QATCH-Technologies/QATCH_MUX_PCB/SVG/QATCH_MUX_PCB_v1-front.png

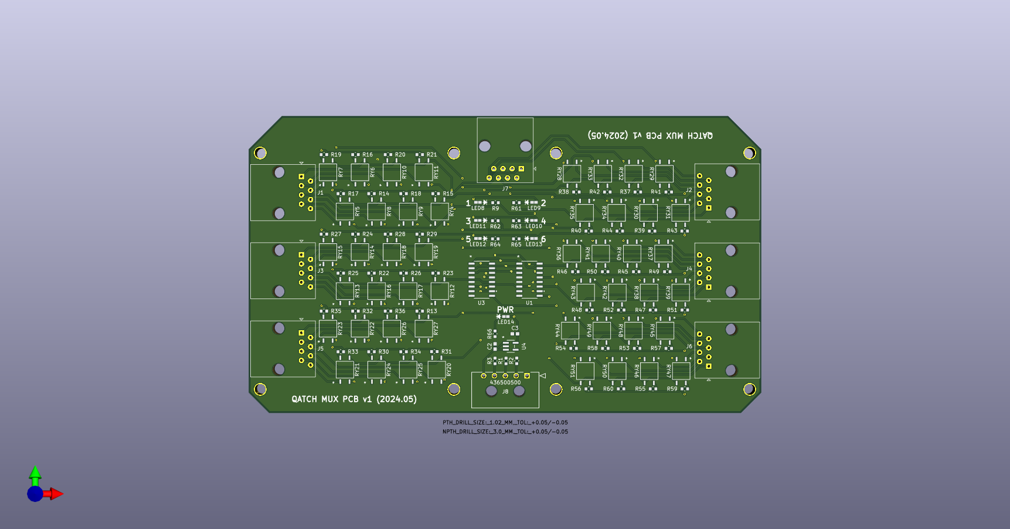
SVG/QATCH_MUX_PCB_v1-front.png
