QATCH-Technologies/QATCH_MUX_PCB/SVG/QATCH_MUX_PCB_v1-back.png

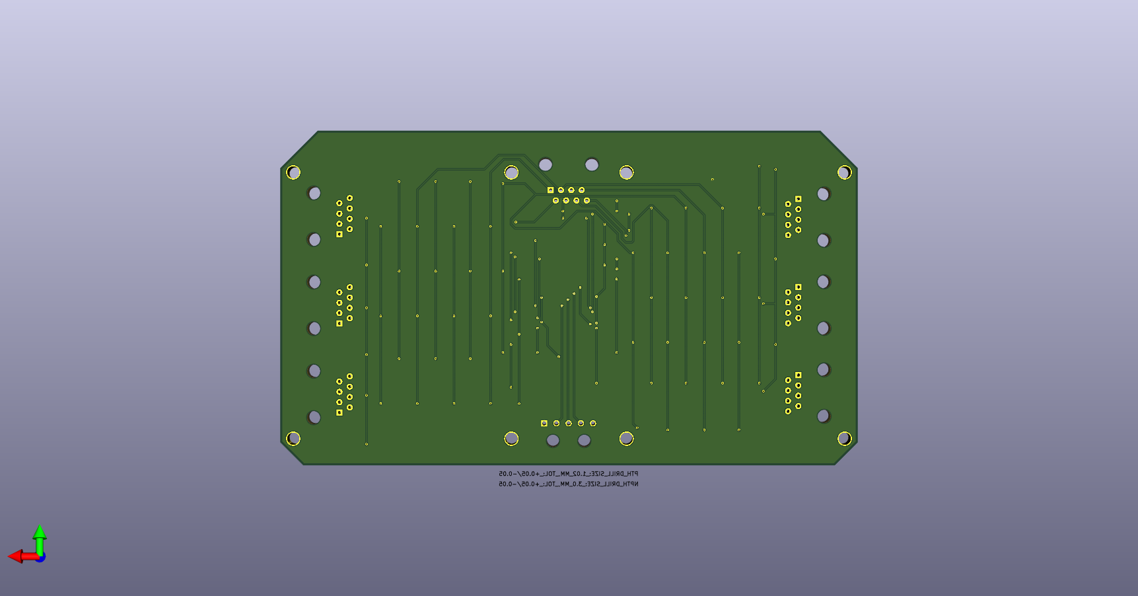
SVG/QATCH_MUX_PCB_v1-back.png
