QATCH-Technologies/QATCH_MUX_PCB/README.md

# QATCH_MUX_PCB
KiCad model for MUX switching multiplex system sensor signals with SSRs (4x6)
