QATCH-Technologies/QATCH_MUX_PCB/(commit log)

2024-05-16 Initial import of KiCad project
    [QATCH_MUX_PCB_v1.kicad_pcb, QATCH_MUX_PCB_v1.kicad_sch, QATCH_MUX_PCB_v1.sch, Scheme-it-export-QATCH-2024-04-09-15-52_MAX_PCB.sch, Scheme-it-export-QATCH-2024-04-09-15-52_QATCH_PCB.kicad_sch, Scheme-it-export-QATCH-2024-04-09-15-52_QATCH_PCB.sch, Scheme-it-export-QATCH-2024-04-09-15-52_TEC_PCB.sch]
2024-05-17 Add 10k pulldown resistors to MUX control input signals Add fabrication outputs
    [BOM-QATCH_MUX_PCB_v1.csv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]
2024-05-21 Allow BOM files in repo
2025-04-10 Committing local changes, add fabrication outputs for v1
    [BOM-QATCH_MUX_PCB_v1.csv, Direct_Wiring.kicad_sch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]
